anish-006t/5-Band-Audio-Equalizer-and-Analyzer/Report.pdf

# Audio Equalizer

# and

# Analyzer

### Anish Toshniwal (2024102009)

### Anushka Saini (2024102052)

### May 6, 2026

Abstract

This report details the design, simulation, and hardware implementation of a 5-band audio equalizer.

The system utilizes multiple-feedback (MFB) Butterworth bandpass filters to isolate distinct audio

frequency bands ranging from 20 Hz to 20 kHz. The filtered signals are processed through variable

gain controls, peak envelope detectors, a summing amplifier, and a Class AB power amplifier. The

system also includes an audio spectrum analyzer matrix. The report evaluates the theoretical

calculations against simulated and measured results, providing a comprehensive analysis of

component tolerances, parasitic effects, and design limitations.

## Contents

1 Introduction | 1
2 System Overview | 1
3 Filter Stage Design: 5 Bandpass Filters | 2
4 Signal Processing and Output Stages | 4
5 Simulation and Measured Results | 12
5.1.2 | Outputs for the a few bands a specific frequencies with gain = 0dB for all gain

ii

6 Measurements and Experimental Observations | 20
7 Analysis and Discussion | 20
8 Conclusion | 22

iii

## 1 Introduction

The objective of this project is to develop a 5-band audio equalizer capable of enhancing and cus-

tomizing audio quality by independently adjusting specific frequency ranges according to user pref-

erence. Equalizers are fundamental components in audio engineering, allowing for the compensation

of room acoustics, speaker deficiencies, or personal aesthetic preferences. This project demonstrates

the practical application of active analog filtering, signal summation, and power amplification.

## 2 System Overview

### 2.1 Block Diagram

The architecture of the 5-band audio equalizer operates through a parallel processing topology. The

implementation involves splitting the input audio signal into five distinct frequency bands using

fourth-order multi-feedback (MFB) Butterworth bandpass filters. The gain of each band is inde-

pendently controlled using potentiometers to adjust different frequency ranges according to user pref-

erence. The filtered signals are then combined using a summing amplifier to generate the modified

audio output, which is reproduced through a speaker. Furthermore, the system includes a frequency

response display for analyzing the effect of gain variation across different bands, demonstrating the

practical implementation of audio signal processing, active filters, and operational amplifier-based

control circuits.

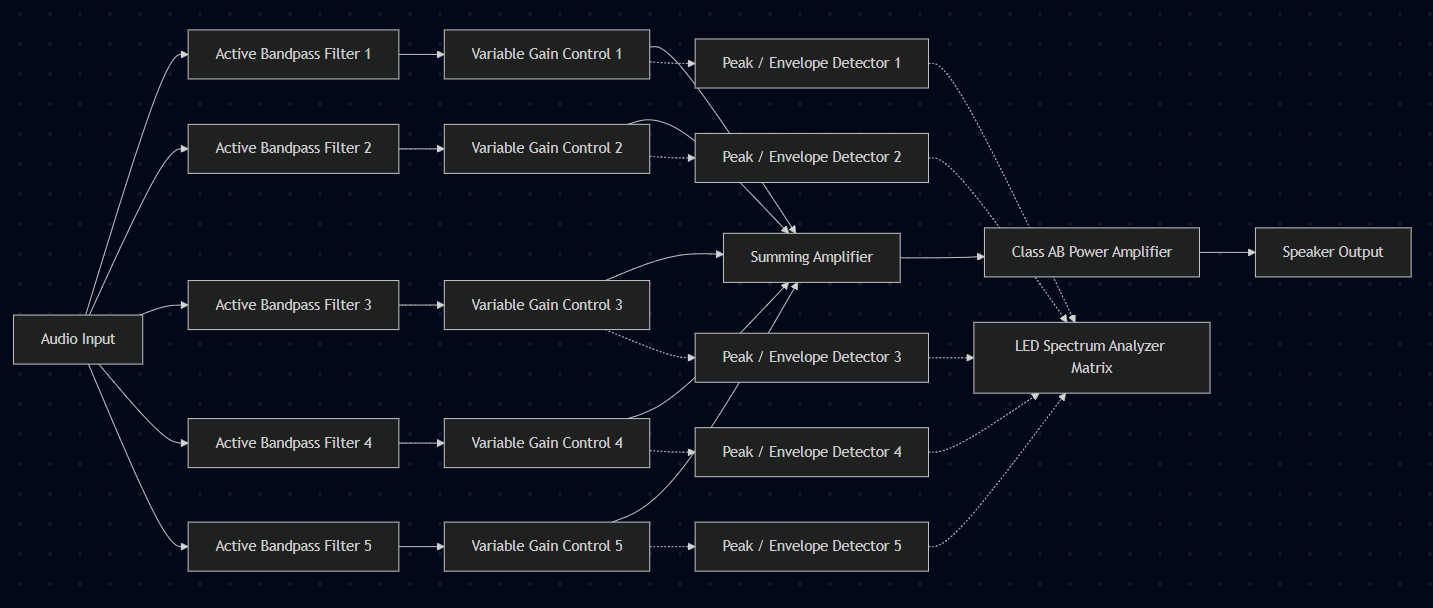
[picture p1: figure]

Figure 1: System block diagram illustrating signal flow from audio input to speaker and audio ana-

lyzer output.

### 2.2 Circuit Diagram

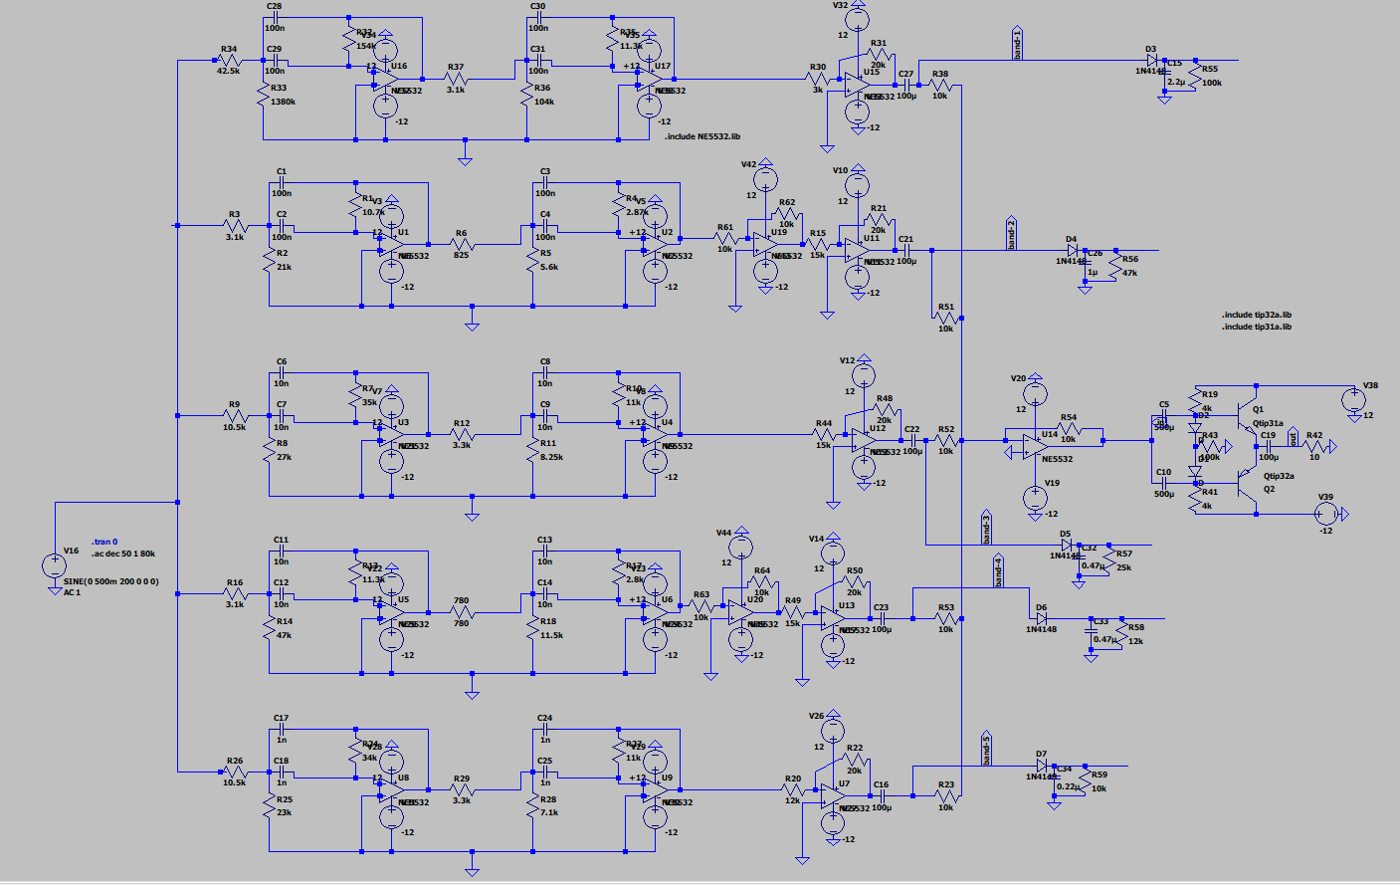
[picture p2: figure]

Figure 2: Complete schematic diagram of the 5-band audio equalizer.

## 3 Filter Stage Design: 5 Bandpass Filters

The core of the frequency separation relies on active bandpass filters. The audio spectrum (20 Hz to

20 kHz) is divided into five adjacent bands.

### 3.1 Frequency Band Walkthrough

The system targets the following specific frequency ranges, ensuring complete coverage of the audible

spectrum:

- Band 1 (Sub-Bass/Bass): 20 Hz – 350 Hz
- Band 2 (Low-Midrange): 350 Hz – 1 kHz
- Band 3 (Midrange): 1 kHz – 3 kHz
- Band 4 (High-Midrange): 3 kHz – 10 kHz
- Band 5 (Treble/Air): 10 kHz – 20 kHz

### 3.2 Filter Topology Analysis

To achieve the desired frequency isolation, an active filter topology must be selected.

### 3.2.1 Topology Comparison: MFB vs. Sallen-Key

When implementing active bandpass filters, it is crucial to select a topology that meets the demands

of audio equalization. The following table compares the characteristics of Multiple Feedback (MFB)

and Sallen-Key topologies to justify our design choice:

Table 1: Comparison between Multiple Feedback (MFB) and Sallen-Key Topologies

Multiple Feedback (MFB) | Sallen-Key
Higher Q-factor and sharper band separation | Lower selectivity for bandpass filters
Better gain and Q control | Limited high-Q performance
More stable for narrow bandwidth filters | Can become unstable at high Q
Reduced overlap between adjacent bands | More cross-band interference

Better suited for bandpass equalizer applications Mostly preferred for low-pass/high-pass filters

### 3.2.2 Butterworth Response and Filter Selection

The project uses fourth order multi-feedback (MFB) Butterworth bandpass filters to accurately sep-

arate the input audio signal into distinct frequency bands with sharp selectivity and minimal band

overlap. The Butterworth response ensures a maximally flat and low-distortion output, preserving au-

dio quality, while the MFB topology provides high stability, compact implementation, efficient gain

control, and reliable performance, making it highly suitable for practical audio equalizer applications.

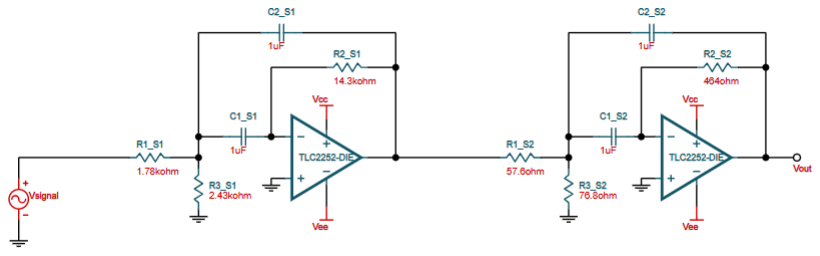
[picture p3: figure]

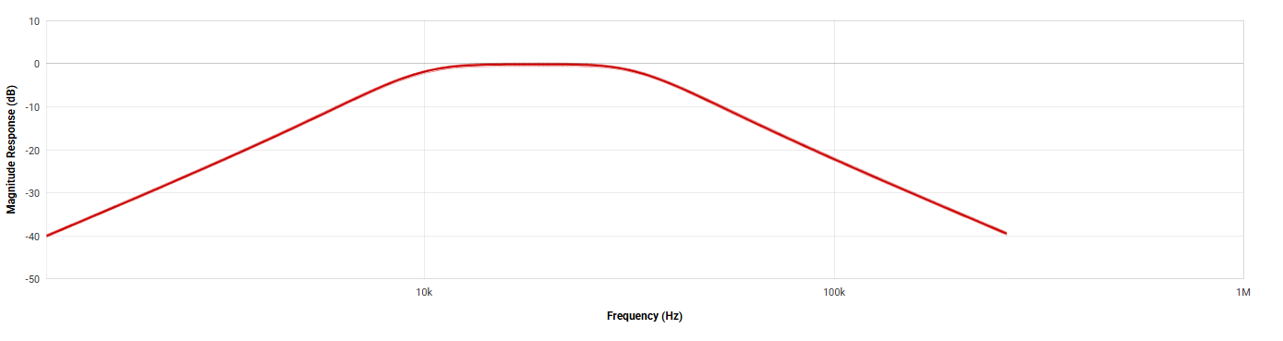
[picture p4: figure]

Figure 3: Schematic of the fourth-order MFB Butterworth bandpass filter and its corresponding mag-

nitude response.

### 3.3 Calculations and Implementation

To adhere to the stringent 25-page limit of this report, the comprehensive step-by-step mathematical

derivations and component calculations for all five MFB filter bands is added in the link below:

https://drive.google.com/drive/folders/1HjKUTuw6CYNPMXkxBrci83NWthcEkepB

## 4 Signal Processing and Output Stages

### 4.1 Variable Gain and Summing Amplifier

Following the active bandpass filter stage, the audio signal has been separated into five distinct fre-

quency bands. To achieve the equalization effect, the user must be able to independently modify the

amplitude (gain) of each specific frequency component before they are recombined.

### 4.1.1 Variable Gain Control

The output of each of the five bandpass filters, denoted as VBP1 through VBP5, is routed through a linear

potentiometer configured as a voltage divider. This allows the user to apply an attenuation factor, αi

(where 0 ≤ αi ≤ 1), to each band. The adjusted voltage for each band, Vin,i
, entering the summation

stage is given by:

Vin,i = αi

·VBPi | for i ∈ {1,2,3,4,5} | (1)

### 4.1.2 Signal Recombination via Summing Amplifier

To reconstruct the full audio spectrum, these individually adjusted frequency bands must be added

back together. This is achieved using an inverting summing amplifier configuration.

The theoretical output voltage Vout of an inverting summing amplifier with a feedback resistor Rf

and individual input resistors Rin,1 through Rin,5 is defined by Kirchhoff’s Current Law at the inverting

node:

Vout = −Rf

Vin,1

Rin,1

+

Vin,2

Rin,2

+

Vin,3

Rin,3

+

Vin,4

Rin,4

+

Vin,5

Rin,5

(2)

To ensure that the summing amplifier recombines the signals with a baseline unity gain—meaning

the potentiometers serve as the sole amplitude control—all input resistors are chosen to be equal to

the feedback resistor (Rin,i = Rf). This simplifies the derivation to:

Vout = −

Rf

Rin

5
∑

i=1

Vin,i = −

5
∑

i=1

αiVBPi | (3)

### 4.1.3 Summing Amplifier Implementation

Based on the system design, the summing amplifier is implemented using an NE5532 low-noise audio

operational amplifier, powered by a dual supply of ±12V to provide ample headroom and prevent

signal clipping.

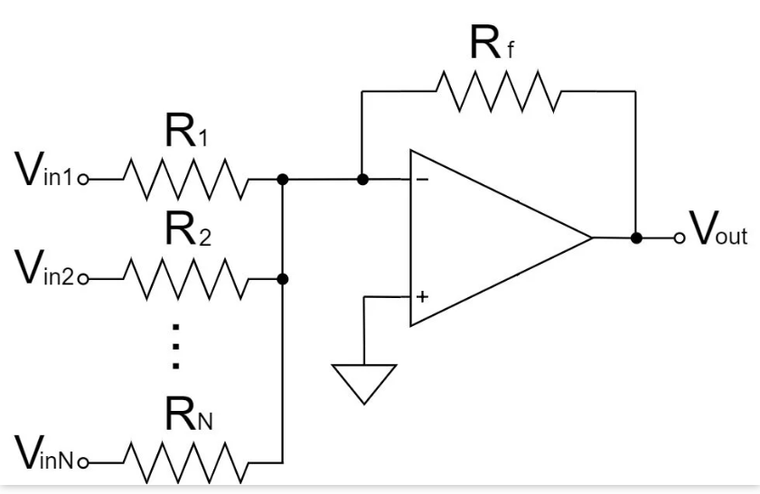
[picture p5: figure]

Figure 4: Schematic of the NE5532 inverting summing amplifier

In our circuit, the feedback resistor (Rf) is set to 10kΩ. To maintain unity gain during summation,

the five input resistors connecting the potentiometers to the inverting terminal of the NE5532 are also

set to 10kΩ. Substituting these practical values into our derived equation yields:

Vout = −

10 kΩ
10 kΩ
Vin,1 +Vin,2 +Vin,3 +Vin,4 +Vin,5
(4)

Vout = −

Vin,1 +Vin,2 +Vin,3 +Vin,4 +Vin,5
(5)

This confirms that the circuit successfully reconstructs the equalized audio signal. Note that the

output is inverted (180° phase shift) relative to the inputs.

### 4.2 Envelope Detector

To provide visual feedback, the output of each bandpass filter is tapped by a peak/envelope detec-

tor. This circuit converts the AC audio signal into a varying DC voltage proportional to the signal’s

amplitude within that specific band.

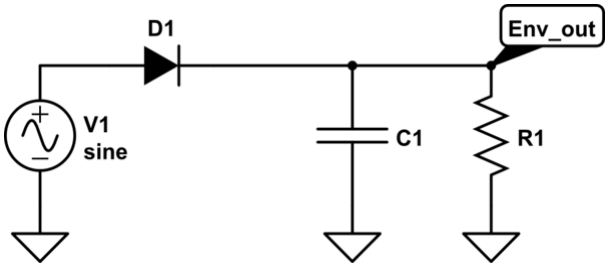
[picture p6: figure]

Figure 5: Envelope Detector

### 4.2.1 Implementation and Calculations

The implementation utilizes 1N4148 high-speed switching diodes for all envelope as a half-wave

rectifier to focus only on the positive half cycle. This diode introduces a forward voltage drop (Vf ≈

0.7V). Consequently, the audio signal must exceed 0.7V to charge the capacitor. In the context of a

visualizer, this acts beneficially as a rudimentary ”noise gate,” preventing low-level background hiss

from triggering the LEDs.

The dynamic response of the visualizer—how quickly the LEDs light up and fade out—is gov-

erned by the RC time constant (τ) of the capacitor-resistor network. The time constant defines the

time required for the capacitor to discharge to approximately 36.8% of its peak voltage, calculated

using the formula:

τ = R×C | (6)

To ensure optimal tracking across the entire audio spectrum, the component values are scaled

according to their respective frequency bands. The calculations for all five bands are as follows:

- Band 1 (Sub-Bass/Bass: 20 Hz – 300 Hz): Given C15 = 2.2µF and R55 = 100kΩ.

τ1 = 100×10³Ω×2.2×10⁻⁶ F = 0.220s = 220ms

- Band 2 (Low-Midrange: 300 Hz – 1 kHz): Given C26 = 1µF and R56 = 47kΩ.

τ2 = 47×10³Ω×1×10⁻⁶ F = 0.047s = 47ms

- Band 3 (Midrange: 1 kHz – 3 kHz): Given C32 = 0.47µF and R57 = 25kΩ.

τ3 = 25×10³Ω×0.47×10⁻⁶ F = 0.01175s = 11.75ms

- Band 4 (High-Midrange: 3 kHz – 10 kHz): Given C33 = 0.47µF and R58 = 12kΩ.

τ4 = 12×10³Ω×0.47×10⁻⁶ F = 0.00564s = 5.64ms

- Band 5 (Treble/Air: 10 kHz – 20 kHz): Given C34 = 0.22µF and R59 = 10kΩ.

τ5 = 10×10³Ω×0.22×10⁻⁶ F = 0.0022s = 2.2ms

### 4.2.2 Design Justification

The calculated time constants intentionally decrease as the frequency band increases, which is highly

optimal for an audio spectrum analyzer. Lower frequency signals (like Band 1 at 20 Hz) have longer

wavelengths and slower cycles. If τ1 were too short, the capacitor would discharge rapidly between

these slow cycles, causing the bass LEDs to visibly flicker. Therefore, a longer time constant of

220 ms is used to smooth the low-frequency envelope.

Conversely, high-frequency signals (like Band 5 up to 20 kHz) contain fast, transient musical

elements like cymbal crashes. By reducing the time constant to 2.2 ms for Band 5, the DC output

is able to track the rapid rhythmic envelope of treble sounds responsively. This scaled approach

strikes the ideal balance, ensuring smooth and accurate visual representation across the entire audio

spectrum.

### 4.3 Audio Analyzer Matrix

To provide real-time visual feedback of the equalization, the system features a 5-band LED spectrum

analyzer matrix that translates the DC envelope voltages into proportional amplitude displays.

### 4.3.1 Architecture and Calculation

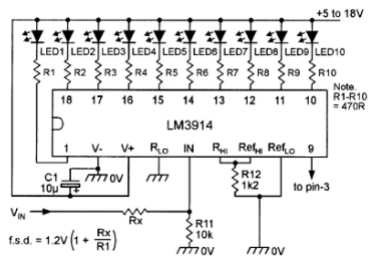
[picture p7: figure]

Figure 6: LM3914 in Bar display configuration

The matrix consists of five parallel strips of 9 LEDs (one strip per frequency band). These are driven

by five LM3914 Bar Display Driver ICs.

The below formula (ignore the one in image) is used to set the value of DC voltage for the last

LED to glow.

f.s.d. = 1.2V
1+

Rx

R11
(7)

Given an initial peak-to-peak voltage (Vpp) of 8.6 V (discussed further in section 6) from the filter

stage, the theoretical maximum DC voltage (Vmax) produced by the envelope detector is determined

by halving the peak-to-peak value to find the AC amplitude, and then subtracting the forward voltage

drop (Vf ≈ 0.7 V) of the rectifying diode:

Vmax =

Vpp
2
−Vf | (8)

Substituting the known values into the equation yields the final maximum voltage stored by the

capacitor:

Vmax =

8.6 V
2
−0.7 V

Vmax = 4.3 V−0.7 V

Vmax = 3.6 V

Since the maximum envelope voltage is calculated as 3.6 V, we set the full-scale deflection (f.s.d.)

of the display driver to match this peak (f.s.d. = 3.6 V).

Using the provided reference voltage formula and a standard chosen value of R11 = 10 kΩ, we

can calculate the required value for the feedback resistor (Rx) as follows:

f.s.d. = 1.2 V
1+

Rx

R11

3.6 V = 1.2 V
1+

Rx
10 kΩ

3.6
1.2

= 1+

Rx
10 kΩ

3 = 1+

Rx
10 kΩ

2 =

Rx
10 kΩ

Rx = 2×10 kΩ

Rx = 20 kΩ

### 4.3.2 Principle of Operation

The operation for each frequency band follows a direct threshold logic:

1. Input: The smoothed DC voltage from the envelope detector is fed into the signal input (Pin 5)

of the LM3914.

2. Comparison: Inside the IC, this voltage is compared against a precision resistor-divider net-

work connected to a bank of ten operational amplifiers acting as comparators.

3. Illumination: As the DC voltage rises with louder audio signals, it sequentially exceeds these

internal thresholds. Each triggered comparator sinks current, pulling its output low and illumi-

nating the corresponding LED in proportion to the signal’s peak amplitude.

### 4.4 Class AB Power Amplifier

The final recombined audio signal from the summing amplifier is a voltage-level signal that lacks

the current-driving capability necessary to actuate a standard low-impedance loudspeaker. To resolve

this, a Class AB push-pull power amplifier is implemented. This topology provides the high current

required by the load while utilizing a biasing network to effectively eliminate the crossover distortion

inherent in pure Class B amplifiers.

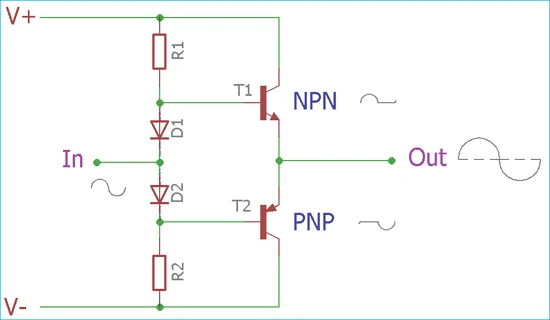
[picture p8: figure]

Figure 7: Schematic of the Class AB push-pull power amplifier featuring TIP31A/TIP32A comple-

mentary transistors and a diode biasing network.

### 4.4.1 Transistor Selection

As shown in Figure 7, the output stage utilizes a complementary pair of bipolar junction transistors

(BJTs): the TIP31A (NPN, Q1) and the TIP32A (PNP, Q2). These are robust, medium-power tran-

sistors capable of handling continuous collector currents up to 3 A and significant power dissipation,

making them highly suitable for driving a 10Ω audio load (R42).

### 4.4.2 Biasing Network and Derivation

In a standard Class B push-pull amplifier, the transistors remain entirely off until the input audio signal

exceeds their base-emitter turn-on voltage (VBE ≈ 0.7V). This dead zone creates severe crossover

distortion at the zero-crossing of the AC signal.

To achieve Class AB operation, the transistors are slightly forward-biased using a constant voltage

drop created by two series diodes. Because the diodes are manufactured from the same semiconductor material as the transistors, their forward voltage drops closely track the VBE requirements of the BJTs.

The biasing network is powered by the dual ±12V supply (VCC and VEE) through identical 4kΩ

resistors (R19 and R41). The required DC bias current (Ibias) flowing through this network to establish

the voltage drop can be calculated using Kirchhoff’s Voltage Law (KVL):

Ibias =

VCC −VEE −2VD

R19 +R41

(9)

Assuming a standard forward diode drop VD ≈ 0.7V:

Ibias =

12V−(−12V)−1.4V
4000Ω+4000Ω

=

22.6V
8000Ω
≈ 2.825 mA | (10)

This 2.825 mA quiescent current is sufficient to keep the diodes active. Consequently, the voltage

difference between the bases of Q1 and Q2 is fixed at approximately 1.4V (2 × 0.7V). Because

VB1 −VB2 = 1.4V, both transistors are held exactly at the threshold of conduction (VBE1 + |VBE2| ≈

1.4V). When the AC audio signal is coupled into the bases via the 500µF capacitors (C5 and C10),

one transistor immediately conducts the positive half-cycle while the other smoothly takes over for

the negative half-cycle without any dead zone.

### 4.4.3 Expected Output Power

The output signal is passed through a 100µF DC-blocking coupling capacitor to a 10Ω simulated

speaker load . The theoretical maximum unclipped AC peak voltage (Vp) at the output is limited by

the supply rails minus the saturation voltage of the transistors (VCE(sat) ≈ 1.2V for TIP31/32).

Assuming a maximum practical peak output voltage swing of Vp ≈ 10V, the expected Root Mean

Square (RMS) voltage is:

Vrms =

Vp
√
2

=

10V
1.414
≈ 7.07V | (11)

The expected maximum average audio power (Pout) delivered to the 10Ω load is calculated as:

Pout =

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
(12)

Pout =

(10V)

2
2×10Ω

=

100
20
= 5 Watts | (13)

This derivation demonstrates that the chosen configuration safely supplies 5 W of continuous

power to the load, which is well within the thermal and current limits of the selected TIP31A/TIP32A

transistors.

## 5 Simulation and Measured Results

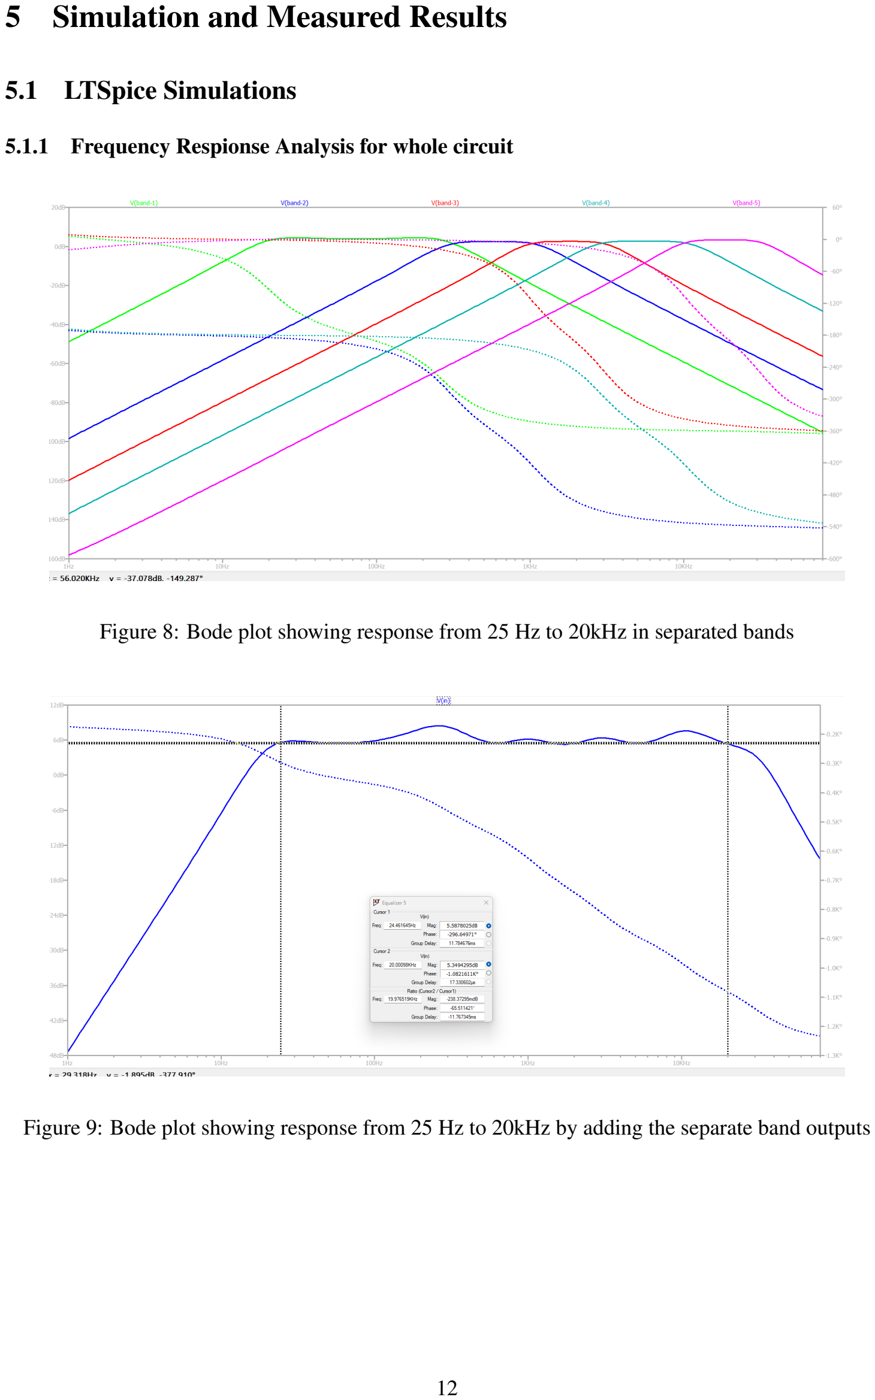
[picture p9: page 15]

### 5.1 LTSpice Simulations

### 5.1.1 Frequency Respionse Analysis for whole circuit

Figure 8: Bode plot showing response from 25 Hz to 20kHz in separated bands

Figure 9: Bode plot showing response from 25 Hz to 20kHz by adding the separate band outputs

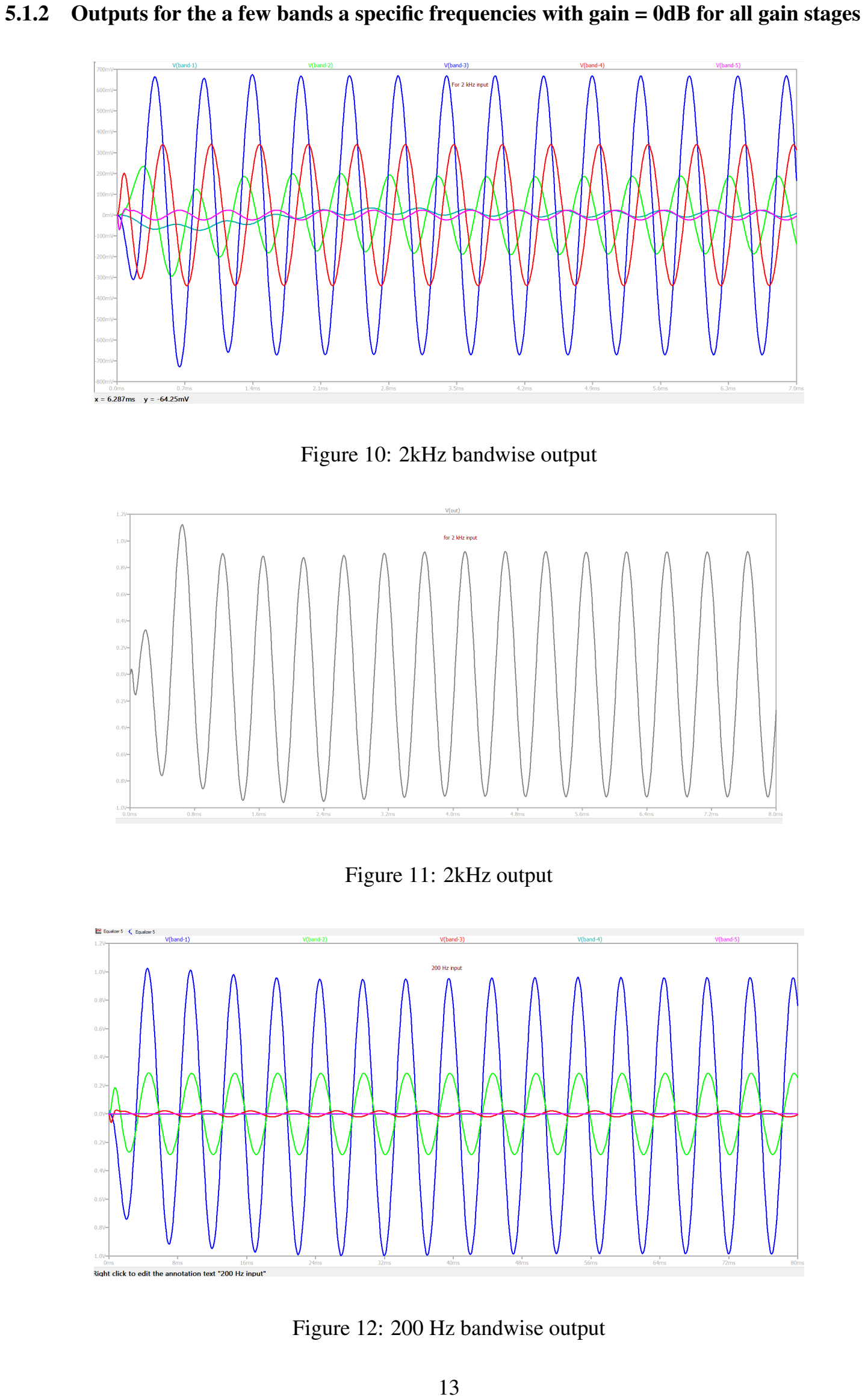
[picture p10: page 16]

5.1.2 Outputs for the a few bands a specific frequencies with gain = 0dB for all gain stages

Figure 10: 2kHz bandwise output

Figure 11: 2kHz output

Figure 12: 200 Hz bandwise output

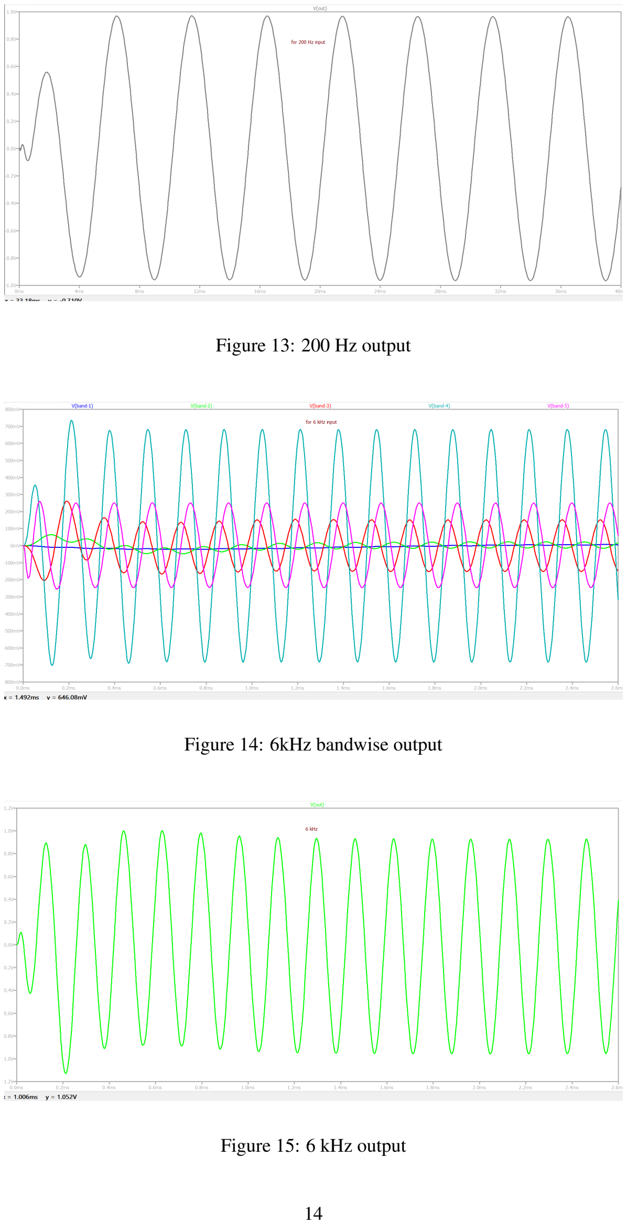
[picture p11: page 17]

Figure 13: 200 Hz output

Figure 14: 6kHz bandwise output

Figure 15: 6 kHz output

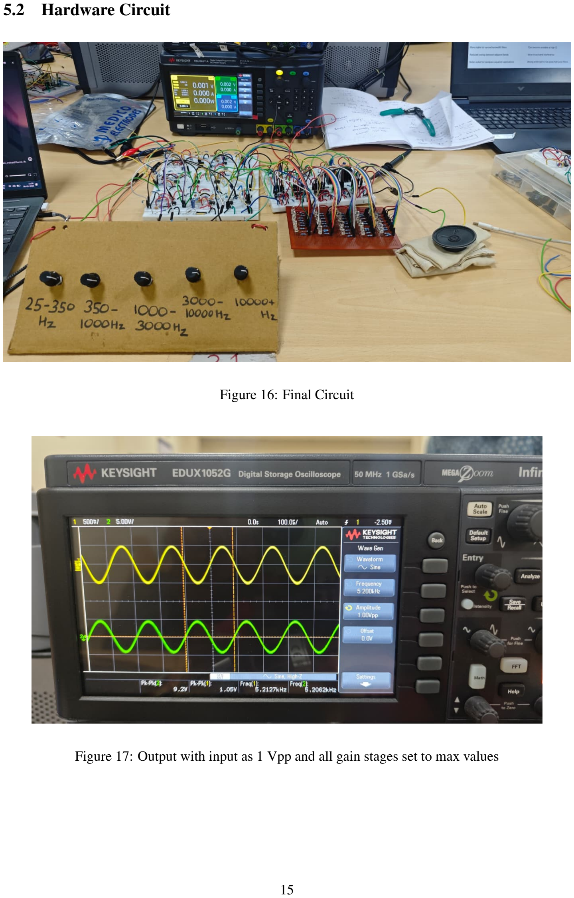
[picture p12: page 18]

### 5.2 Hardware Circuit

Figure 16: Final Circuit

Figure 17: Output with input as 1 Vpp and all gain stages set to max values

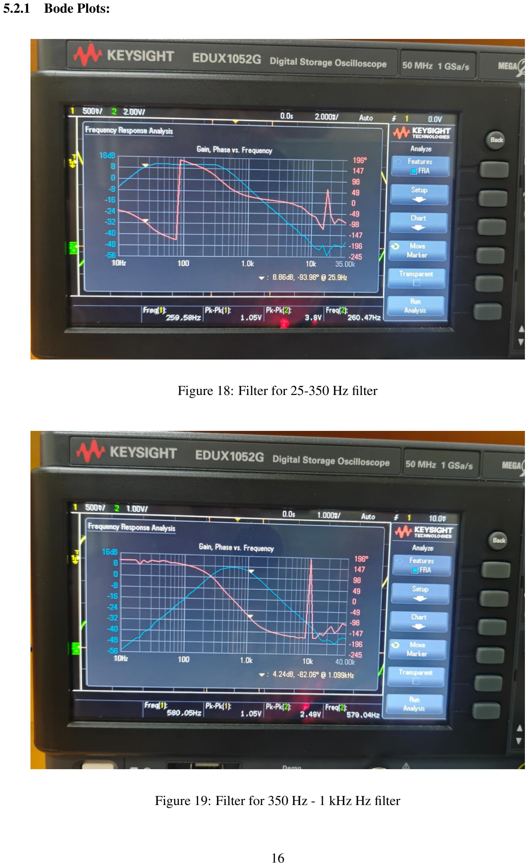
[picture p13: page 19]

### 5.2.1 Bode Plots:

Figure 18: Filter for 25-350 Hz filter

Figure 19: Filter for 350 Hz - 1 kHz Hz filter

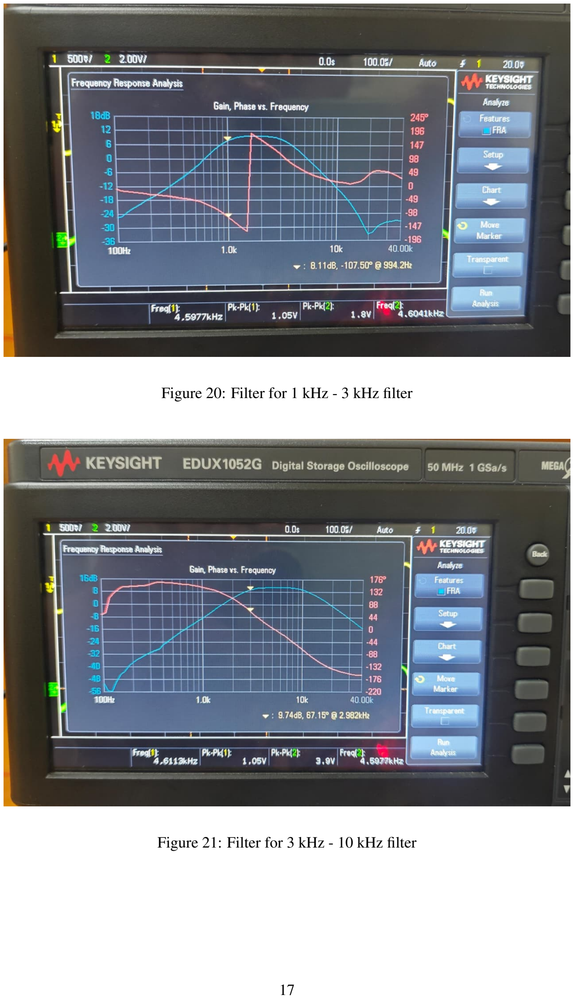
[picture p14: page 20]

Figure 20: Filter for 1 kHz - 3 kHz filter

Figure 21: Filter for 3 kHz - 10 kHz filter

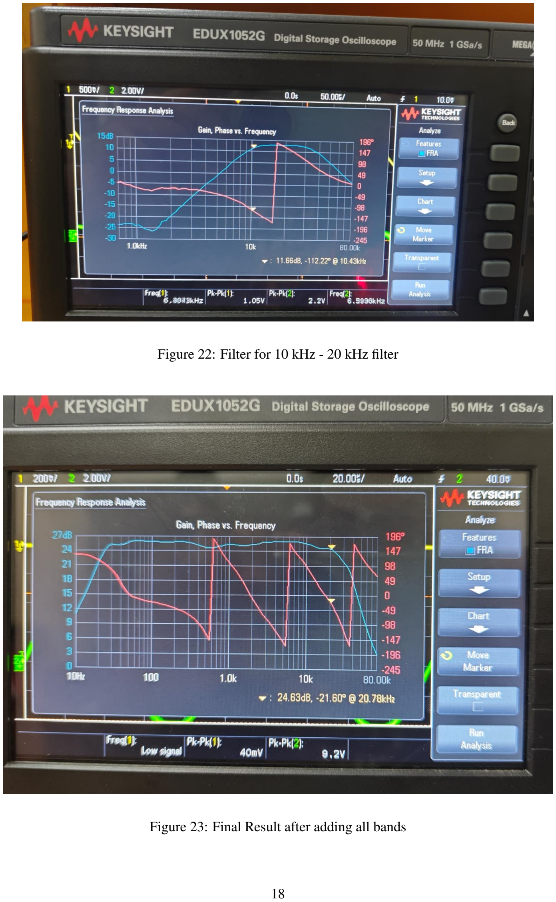
[picture p15: page 21]

Figure 22: Filter for 10 kHz - 20 kHz filter

Figure 23: Final Result after adding all bands

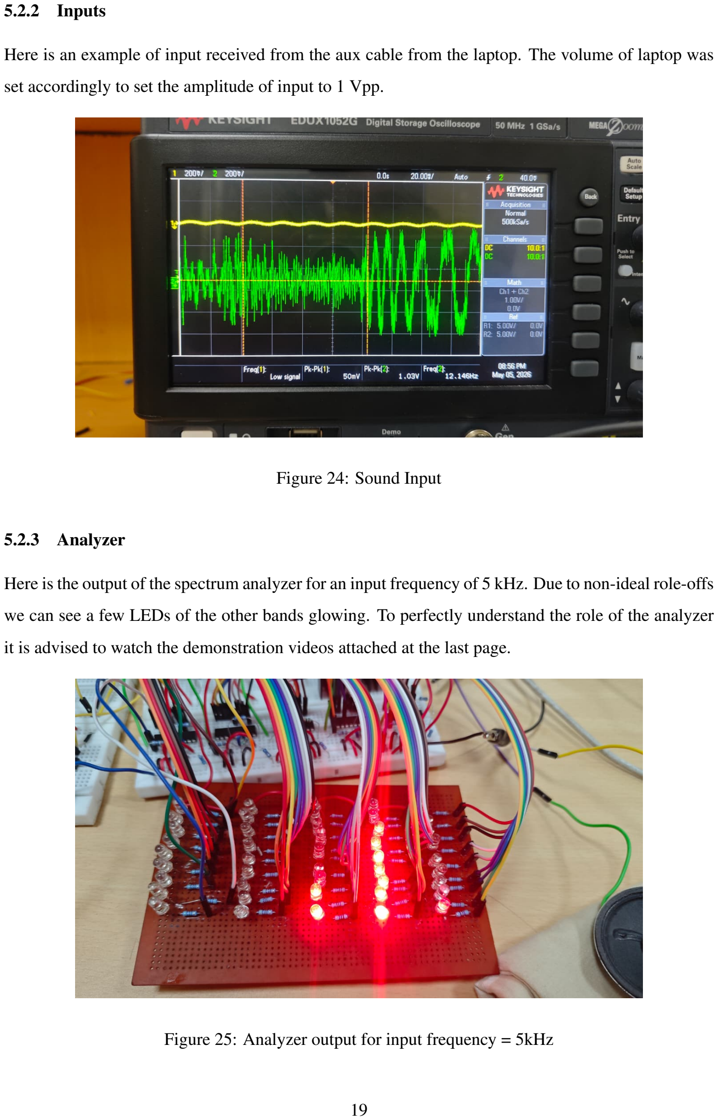
[picture p16: page 22]

### 5.2.2 Inputs

Here is an example of input received from the aux cable from the laptop. The volume of laptop was

set accordingly to set the amplitude of input to 1 Vpp.

Figure 24: Sound Input

### 5.2.3 Analyzer

Here is the output of the spectrum analyzer for an input frequency of 5 kHz. Due to non-ideal role-offs

we can see a few LEDs of the other bands glowing. To perfectly understand the role of the analyzer

it is advised to watch the demonstration videos attached at the last page.

Figure 25: Analyzer output for input frequency = 5kHz

## 6 Measurements and Experimental Observations

The input signal applied to the circuit was assumed to have an amplitude of:

Vin = 1Vpp | (14)

The maximum achievable gain of each filter stage was set such that the maximum amplitude of the

signal after passing through each filter stage was approximately:

Vmax = 8.6Vpp | (15)

This adjustment ensured nearly uniform amplification across the stages while also preventing

excessive clipping and output distortion in the amplifier section.Reason for se;ecting this value was

After connecting the power amplifier stage, the output voltage of each filter stage was measured

experimentally. It was observed that the output amplitude varied approximately within the range:

9Vpp ≤ Vout ≤ 13Vpp | (16)

depending on the specific filter stage and operating conditions.

The observed voltage amplification across the stages confirms that the power amplifier provided

sufficient gain to the filtered signal while maintaining stable operation across different frequency

bands.

## 7 Analysis and Discussion

While the system successfully demonstrated 5-band audio equalization, several discrepancies between

theoretical models and hardware implementation were observed, presenting specific design challenges

during testing.

### 7.1 Cross-Band Interference

Despite using a maximally flat Butterworth response, overlap between adjacent frequency bands

caused unwanted mixing of frequencies. This spectral overlap reduced the overall selectivity of the

equalizer, meaning large amplitude adjustments to one frequency band slightly colored the frequen-

cies of its neighboring bands.

### 7.2 Complex Fourth Order Bandpass Filter Design

Designing and implementing the fourth-order MFB Butterworth bandpass filters was challenging

due to the strict requirements for precise cutoff frequency tuning and gain adjustment. Maintaining

a stable filter response across the cascaded operational amplifier stages required exact impedance

matching and careful selection of feedback components.

### 7.3 Phase Response Mismatch

Phase shifts introduced by the higher-order active filters affected signal synchronization. Because

each band undergoes varying degrees of phase shift (especially near its cutoff frequencies), the recom-

bined audio signal at the summing amplifier experienced minor phase cancellations, which slightly

impacted the overall audio quality and coherence.

### 7.4 Maintaining Audio Quality

Achieving proper amplification without introducing distortion or noise required careful circuit opti-

mization. A notable design limitation is the operational amplifier’s Gain-Bandwidth Product (GBWP)

and slew rate. If an op-amp with insufficient GBWP is used for the 10 kHz - 20 kHz band, it struggles

to maintain the required gain, distorting the response. Furthermore, the Class AB amplifier required

precise diode biasing to prevent trace amounts of crossover distortion at low amplitudes.

### 7.5 Parasitic Effects

Breadboard implementation introduces significant parasitic capacitance between adjacent rows (typi-

cally 2−5 pF) and parasitic inductance in jumper wires. At lower frequencies (Bands 1 and 2), these

effects are negligible. However, in Band 4 and Band 5 (up to 20 kHz), parasitic capacitance can inad-

vertently form low-pass filters, leading to high-frequency roll-off and reduced amplitude response.

### 7.6 Suggestions for Improvement

Grounded in the technical observations above, the following improvements are suggested for future

iterations of this project:

1. PCB Implementation: Migrating the circuit from a breadboard to a properly routed Printed

Circuit Board (PCB) with a dedicated ground plane would drastically minimize parasitic ca-

pacitance, improve stability, and reduce the overall noise floor.

2. Increasing the Number of Bands: Expanding the system from 5 bands to a 7-band or 9-

band graphic equalizer configuration would provide much finer, granular control over the audio

spectrum, allowing users to target specific resonant frequencies more accurately.

3. 6th Order Feedback System: Upgrading the active filters from a 4th-order to a 6th-order MFB

system would steepen the roll-off characteristics outside the passband. This would directly

solve the cross-band interference issue by drastically improving band selectivity.

## 8 Conclusion

The design, simulation, and implementation of a 5-band audio equalizer were successfully executed.

By utilizing Multiple-Feedback Butterworth bandpass filters, the audio spectrum was accurately di-

vided into five distinct controllable bands ranging from 20 Hz to 20 kHz. The integration of envelope

detectors, a summing amplifier, an LED audio analyzer, and a Class AB power amplifier resulted in

a fully functional, user-adjustable audio processing system. Technical analysis confirmed that while

component tolerances, phase shifts, and parasitic effects introduce minor deviations, the fundamental

principles of active analog filtering were effectively demonstrated and validated against theoretical

expectations.

Project Demonstration & Resources:

A complete video demonstration showcasing the fully functional 5-band audio equalizer and real-time

LED spectrum analyzer can be accessed via the following link:

https://drive.google.com/drive/folders/1HjKUTuw6CYNPMXkxBrci83NWthcEkepB

This also includes the filter stage calculations.

## References

[1] A. Sedra and K. Smith, Microelectronic Circuits, 8th ed. Oxford University Press, 2019.
[2] Texas Instruments, Specific Op-Amp Datasheet (e.g., OPA4187), 2021.
[3] https://www.nutsvolts.com/magazine/article/led-graph-circuitsputinreferences.
[4] https://www.electronics-tutorials.ws/filter/filter_7.html
[5] https://spiceman.net/adder-circuit/
