anish-006t/5-Band-Audio-Equalizer-and-Analyzer/LTSpice modules/Equalizer 5.asc

780: res; 780
C1: cap; 100n
C2: cap; 100n
C3: cap; 100n
C4: cap; 100n
C5: cap; 500µ
C6: cap; 10n
C7: cap; 10n
C8: cap; 10n
C9: cap; 10n
C10: cap; 500µ
C11: cap; 10n
C12: cap; 10n
C13: cap; 10n
C14: cap; 10n
C15: cap; 2.2µ
C16: cap; 100µ
C17: cap; 1n
C18: cap; 1n
C19: cap; 100µ
C21: cap; 100µ
C22: cap; 100µ
C23: cap; 100µ
C24: cap; 1n
C25: cap; 1n
C26: cap; 1µ
C27: cap; 100µ
C28: cap; 100n
C29: cap; 100n
C30: cap; 100n
C31: cap; 100n
C32: cap; 0.47µ
C33: cap; 0.47µ
C34: cap; 0.22µ
D1: diode
D2: diode
D3: diode; 1N4148
D4: diode; 1N4148
D5: diode; 1N4148
D6: diode; 1N4148
D7: diode; 1N4148
Q1: npn; Qtip31a
Q2: pnp; Qtip32a
R1: res; 10.7k
R2: res; 21k
R3: res; 3.1k
R4: res; 2.87k
R5: res; 5.6k
R6: res; 825
R7: res; 35k
R8: res; 27k
R9: res; 10.5k
R10: res; 11k
R11: res; 8.25k
R12: res; 3.3k
R13: res; 11.3k
R14: res; 47k
R15: res; 15k
R16: res; 3.1k
R17: res; 2.8k
R18: res; 11.5k
R19: res; 4k
R20: res; 12k
R21: res; 20k
R22: res; 20k
R23: res; 10k
R24: res; 34k
R25: res; 23k
R26: res; 10.5k
R27: res; 11k
R28: res; 7.1k
R29: res; 3.3k
R30: res; 3k
R31: res; 20k
R32: res; 154k
R33: res; 1380k
R34: res; 42.5k
R35: res; 11.3k
R36: res; 104k
R37: res; 3.1k
R38: res; 10k
R41: res; 4k
R42: res; 10
R43: res; 100k
R44: res; 15k
R48: res; 20k
R49: res; 15k
R50: res; 20k
R51: res; 10k
R52: res; 10k
R53: res; 10k
R54: res; 10k
R55: res; 100k
R56: res; 47k
R57: res; 25k
R58: res; 12k
R59: res; 10k
R61: res; 10k
R62: res; 10k
R63: res; 10k
R64: res; 10k
U1: opamp2; NE5532
U2: opamp2; NE5532
U3: opamp2; NE5532
U4: opamp2; NE5532
U5: opamp2; NE5532
U6: opamp2; NE5532
U7: opamp2; NE5532
U8: opamp2; NE5532
U9: opamp2; NE5532
U11: opamp2; NE5532
U12: opamp2; NE5532
U13: opamp2; NE5532
U14: opamp2; NE5532
U15: opamp2; NE5532
U16: opamp2; NE5532
U17: opamp2; NE5532
U19: opamp2; NE5532
U20: opamp2; NE5532
V2: voltage; -12
V3: voltage; 12
V5: voltage; +12
V6: voltage; -12
V7: voltage; 12
V8: voltage; +12
V9: voltage; -12
V10: voltage; 12
V11: voltage; -12
V12: voltage; 12
V13: voltage; -12
V14: voltage; 12
V16: voltage; SINE(0 500m 200 0 0 0); AC 1
V17: voltage; -12
V19: voltage; -12
V20: voltage; 12
V21: voltage; -12
V22: voltage; 12
V23: voltage; +12
V24: voltage; -12
V25: voltage; -12
V26: voltage; 12
V27: voltage; -12
V28: voltage; 12
V29: voltage; +12
V30: voltage; -12
V31: voltage; -12
V32: voltage; 12
V33: voltage; -12
V34: voltage; 12
V35: voltage; +12
V36: voltage; -12
V37: voltage; -12
V38: voltage; 12
V39: voltage; -12
V42: voltage; 12
V43: voltage; -12
V44: voltage; 12
V45: voltage; -12
Named nets: 0, in, out, band-1, band-2, band-3, band-4, band-5
.include NE5532.lib
.include tip31a.lib
.include tip32a.lib
.tran 0
.ac dec 50 1 80k
